IlliniSolarCar/ElecOnboarding24/README.md

# ElecOnboarding24
This is used for Electrical Onboarding for the Fall 2024 Semester

We are excited to get to work with you guys!
