IlliniSolarCar/ElecOnboarding24/Firmware/common/README.md

# common
Code common to all boards in the Brizo repository. This includes all CAN message ID's and structs, helper functions, methods for common hardware, etc.
