IlliniSolarCar/ElecOnboarding24/Hardware/LEDCircuit/LEDCircuit.kicad_pcb

## KiCad design Hardware/LEDCircuit/LEDCircuit.kicad_pcb (2024-09-16)

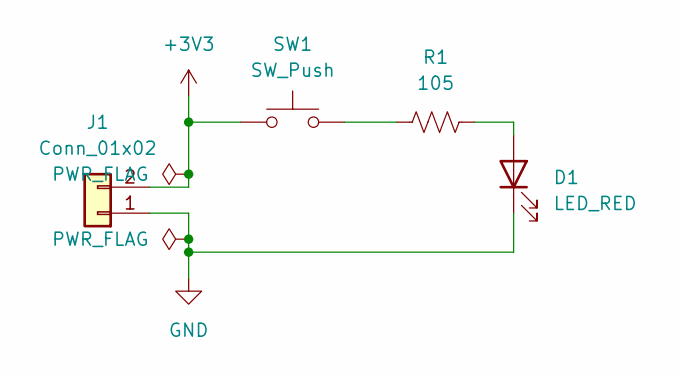
[picture p1: schematic LEDCircuit.kicad_sch, LED Circuit]

Parts:
D1: LED_RED; LED_0603_Symbol_on_F.SilkS
J1: Conn_01x02; Molex_KK-254_AE-6410-02A_1x02_P2.54mm_Vertical
R1: 105; R_0603_1608Metric_Pad0.98x0.95mm_HandSolder
SW1: SW_Push; SW_DIP_SPSTx01_Slide_6.7x4.1mm_W8.61mm_P2.54mm_LowProfile

Connections:
+3V3: J1.2, SW1.1
GND: D1.1 (K), J1.1
unnamed: D1.2 (A), R1.2
unnamed: R1.1, SW1.2

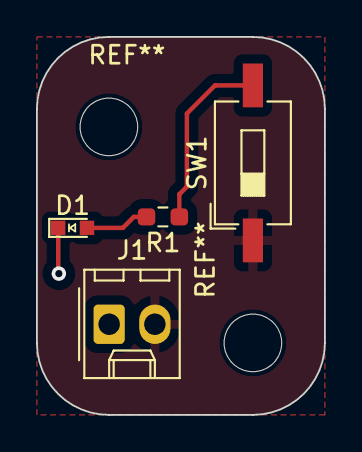
[picture p2: board LEDCircuit.kicad_pcb from above]

Board: 2 copper layers, 16.0 x 21.0 mm, 4 parts (0 on the bottom side), 4 nets.
