IlliniSolarCar/ElecOnboarding24/(commit log)

2023-07-16 Adding Skeleton Directories
    [Lights_Onboarding_LEDDriver_v0_1.sch, Lights_Onboarding_v0_1.kicad_pcb, Lights_Onboarding_v0_1.sch, Template_v0.0_v6.kicad_pcb, Template_v0.0_v6.kicad_sch, master.cfg]
2023-09-04 Template Rename
    [Template_v0.0.kicad_pcb, Template_v0.0.kicad_sch]
2023-09-05 Happy Onboarding
    [Lights_Onboarding_LEDDriver_v0_1.sch, Lights_Onboarding_v0_1.kicad_pcb, Lights_Onboarding_v0_1.sch]
2024-09-16 first hardware project
    [LEDCircuit.kicad_pcb, LEDCircuit.kicad_sch]
2024-09-17 added data sheet
    [LEDCircuit.kicad_sch]
